Kiubek8/Compliant-Pin-Mounting-Replacement/3DFiles/windowHolder_v1.2-Main.3mf

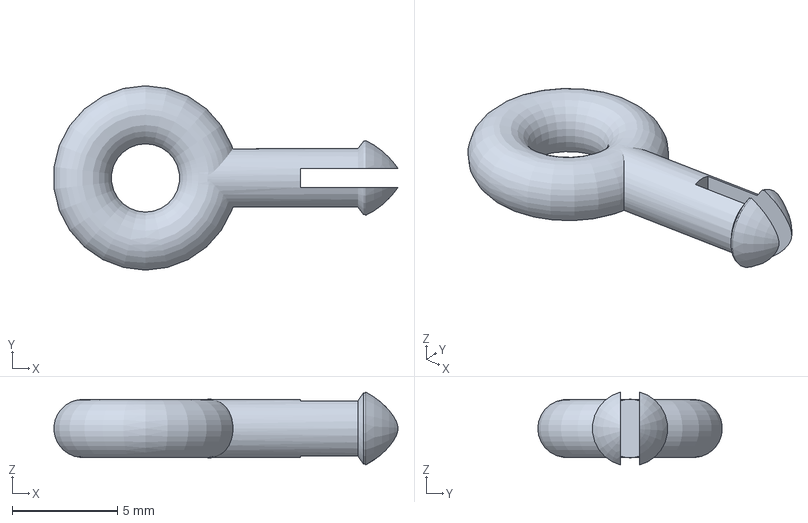
[picture p10: CAD file, 2026-07-13]
3DFiles/windowHolder_v1.2-Main.3mf
16.3 x 8.76 x 3.47 mm
