Kiubek8/Compliant-Pin-Mounting-Replacement/CadFiles/windowHolder_v1.2.FCStd

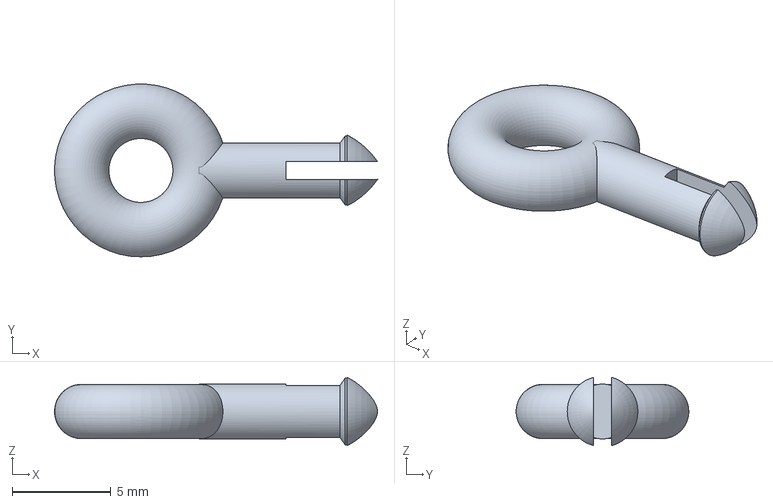
[picture p11: CAD file, 2026-07-13]
CadFiles/windowHolder_v1.2.FCStd
16.4 x 8.75 x 3.47 mm
