Kiubek8/Compliant-Pin-Mounting-Replacement/3DFiles/windowHolder_v0.1-Main.3mf

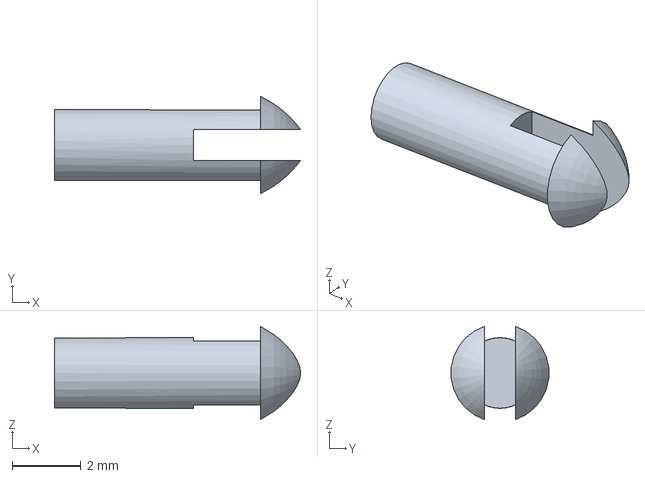
[picture p12: CAD file, 2026-07-13, an earlier design]
3DFiles/windowHolder_v0.1-Main.3mf
7.16 x 2.84 x 2.71 mm
