Kiubek8/Compliant-Pin-Mounting-Replacement/CadFiles/windowHolder_v1.0.FCStd

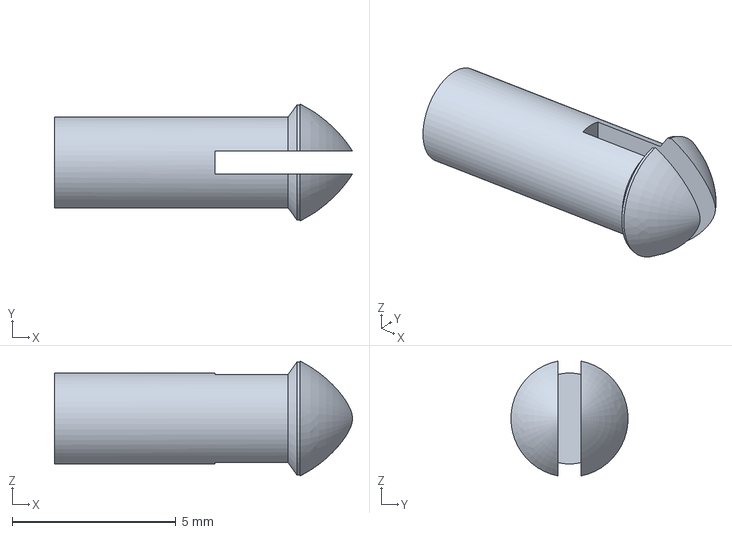
[picture p13: CAD file, 2026-07-13, an earlier design]
CadFiles/windowHolder_v1.0.FCStd
9.10 x 3.58 x 3.51 mm
