Kiubek8/Compliant-Pin-Mounting-Replacement/CadFiles/windowHolder_v0.1.FCStd

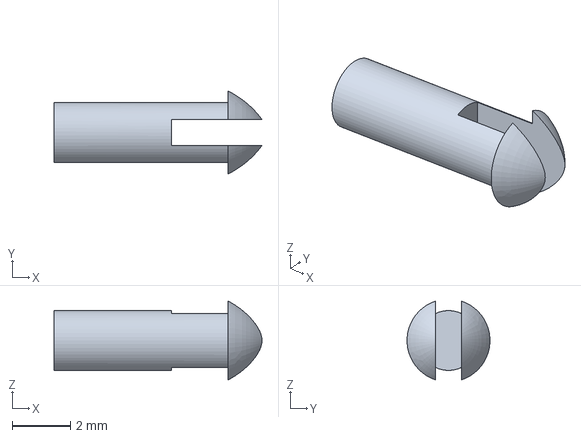
[picture p14: CAD file, 2026-07-12, an earlier design]
CadFiles/windowHolder_v0.1.FCStd
7.17 x 2.85 x 2.71 mm
