Kiubek8/Compliant-Pin-Mounting-Replacement/(list of files, cad)

Other CAD files:
3DFiles/windowHolder_v1.1-Main.3mf
CadFiles/windowHolder_v1.1.FCStd
