Kiubek8/Compliant-Pin-Mounting-Replacement/(commit log)

2026-07-12 Update README.md
    v0.1 prototype update
2026-07-13 Added a ramp on the back
    [windowHolder_v1.0.FCStd]
2026-07-13 Added a donut-style line holder
    [windowHolder_v1.1.FCStd]
2026-07-13 added the working version
    [windowHolder_v1.2.FCStd]
